NikitaKozelko/ModuleLedPanel/doc/pic/QlnexnhgFjM.jpg

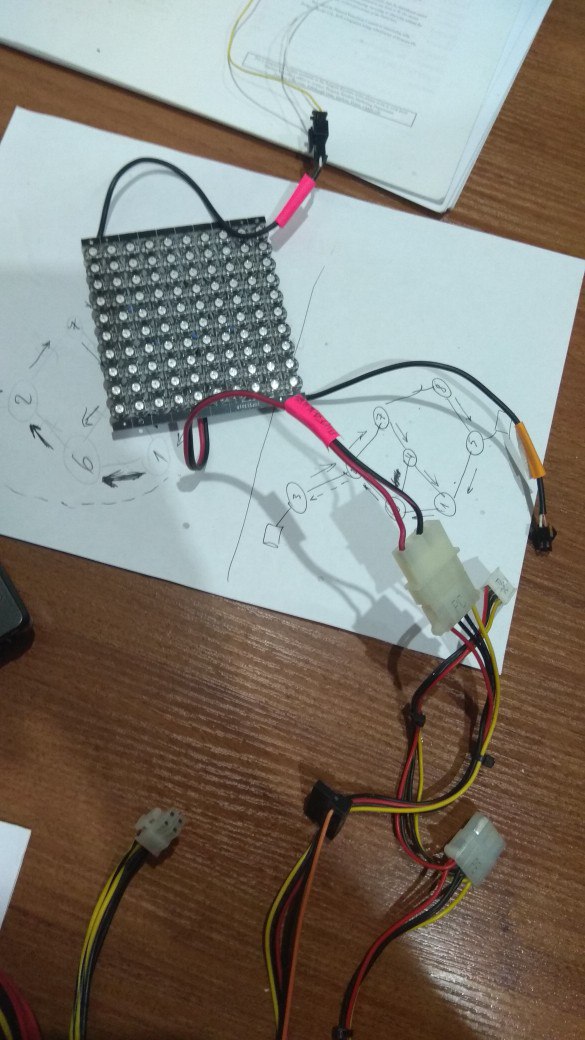
doc/pic/QlnexnhgFjM.jpg
