NikitaKozelko/ModuleLedPanel/doc/pic/BiGQELAHoDM.jpg

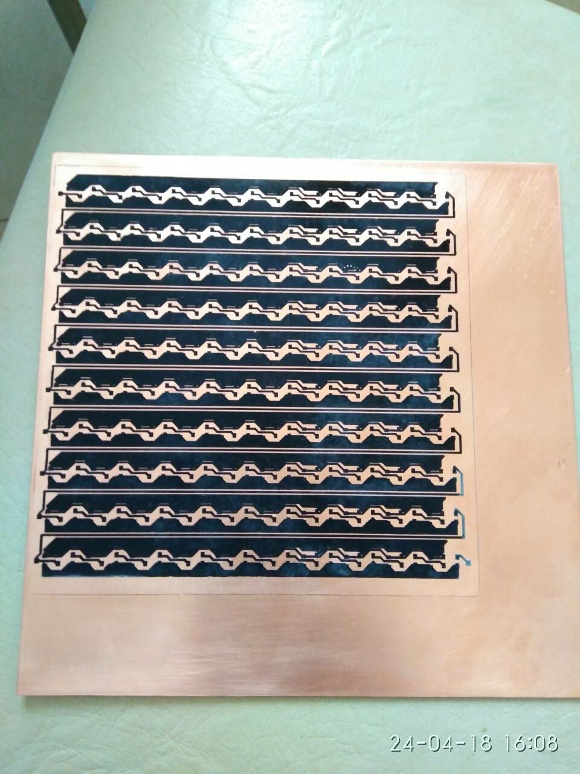
doc/pic/BiGQELAHoDM.jpg
