NikitaKozelko/ModuleLedPanel/doc/Demo.pptx

## Курсовой проект по СИФО ЭВМ “RGB LED-панель с тремя модулями”

студентов группы 550504 Козелько Н. С. и Дорошко В. Э.

## Цель:

- Описание проекта:
- Собрать LED-панель из RGB светодиодов, которая будет отображать текст, вводимый в приложении на компьютере. А также протестировать устройство в условиях, при которых оно должно работать. И решить возникшие проблемы, если они появятся.
- Цель проекта:
- Получить новые знания и умения работы с Arduino, а также проверить уже полученные знания на практике.

## АНалоги

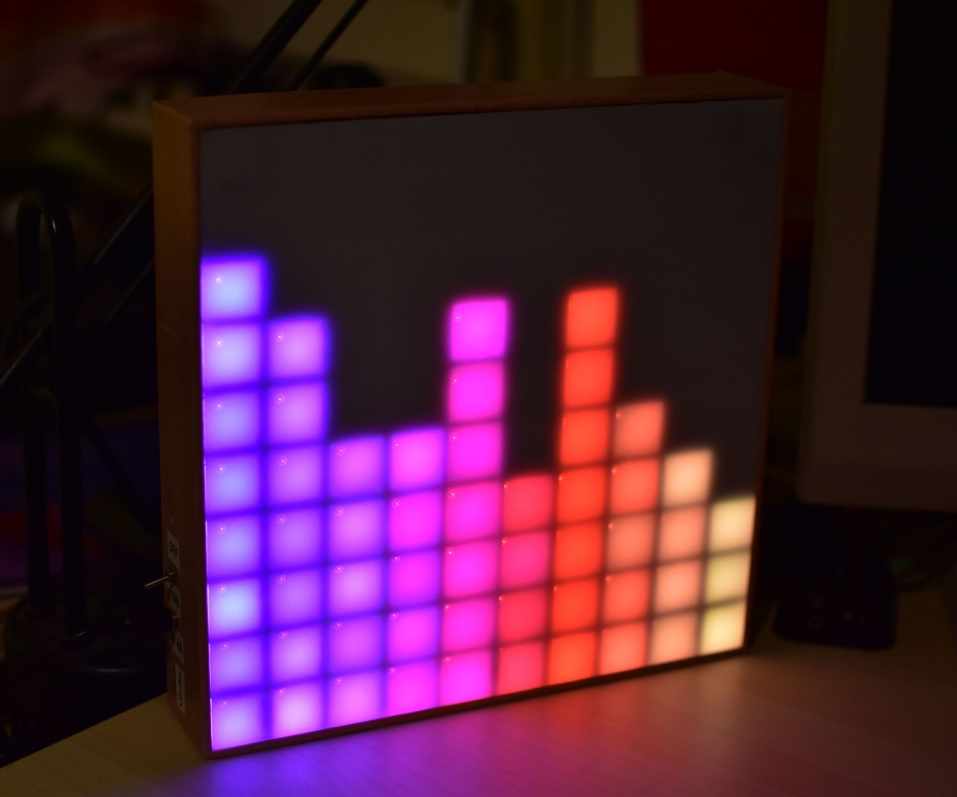
[picture p44: figure]

## Аппаратная часть


светодиод WS2812B

Схема работы

## Проектирование Аппаратной части


## Проектирование Аппаратной части


## Программная часть


## Программная часть


## Заказ деталей


## Вытравливание платы


## Вытравливание платы


## Вытравливание платы


## Вытравливание платы


## Вытравливание платы


## Вытравливание платы


## Вытравливание платы


## Интеграция программной и аппаратной части

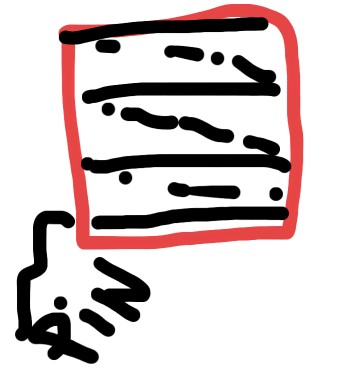
[picture p45: figure]

## Вытравливание платы

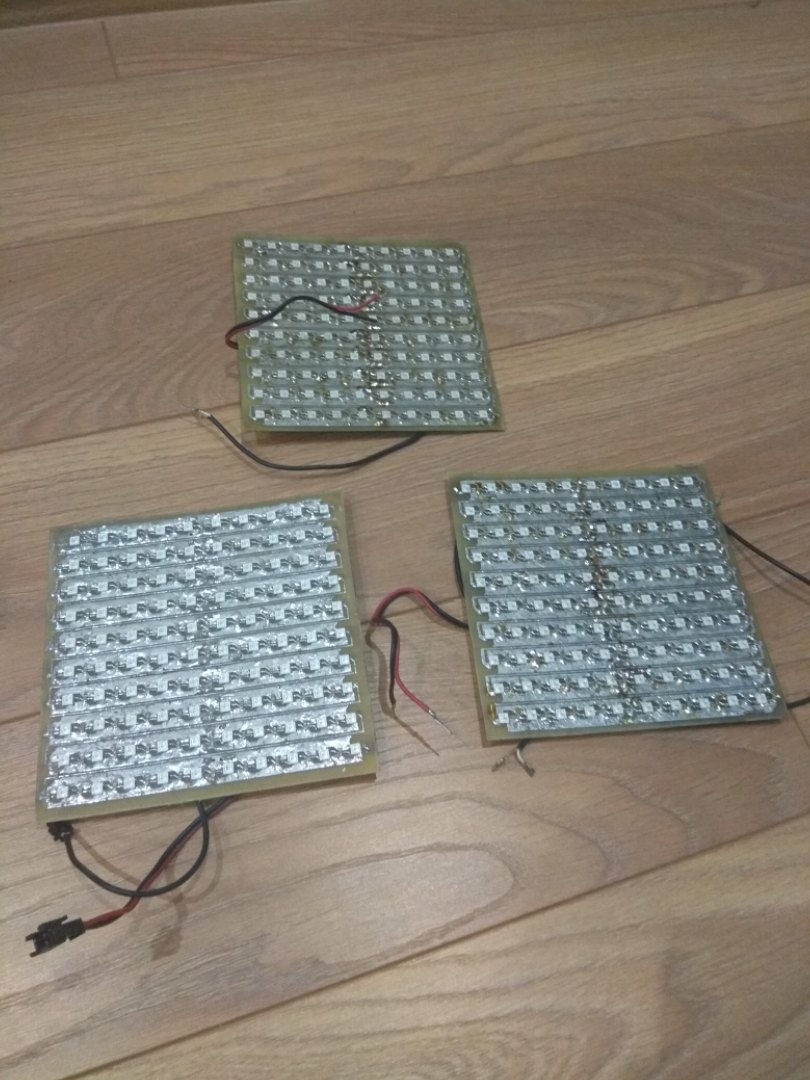
[picture p46: figure]

## Программная часть

Формат команды:
команда:
TEXT для вывода текста
UGLV для вывода изображения в угловом режиме
SNAK для последовательного зажигания всех светодиодов
- цвет:
- каждый цвет задается в формате от 0 до 255
- режим:
- определяет направление сдвига:
- 1: сдвигает слева направо в текстовом режиме
- 2: сдвигает справа налево в текстовом режиме
- 3: сдвигает изображение слева направо в угловом режиме
- 4: сдвигает изображение справа налево в угловом режиме

## Программная часть


## Программная часть


## Программная часть


## Проблемы в программной части

## Спасибо за внимание
