NikitaKozelko/ModuleLedPanel/doc/pic/k7k3CvZeT_w.jpg

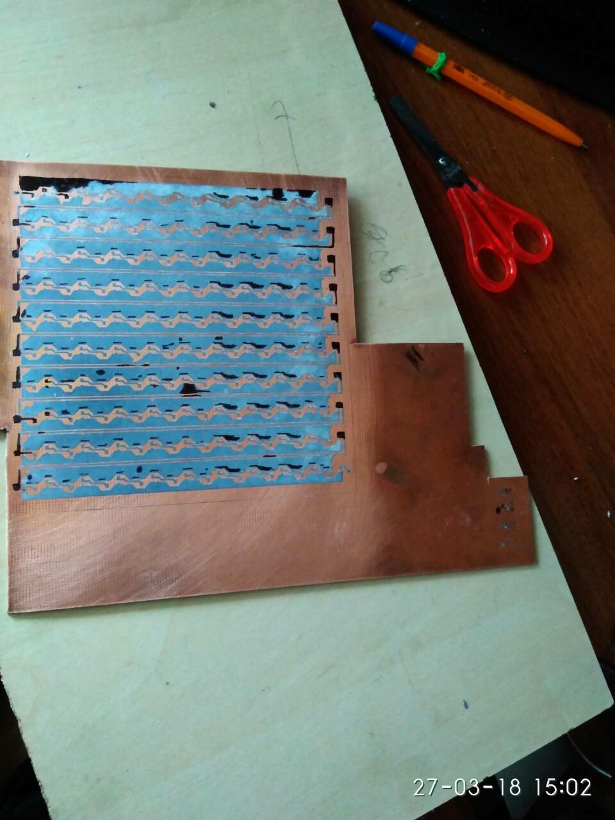
doc/pic/k7k3CvZeT_w.jpg
