NikitaKozelko/ModuleLedPanel/doc/pic/lSbHtu9iDFY.jpg

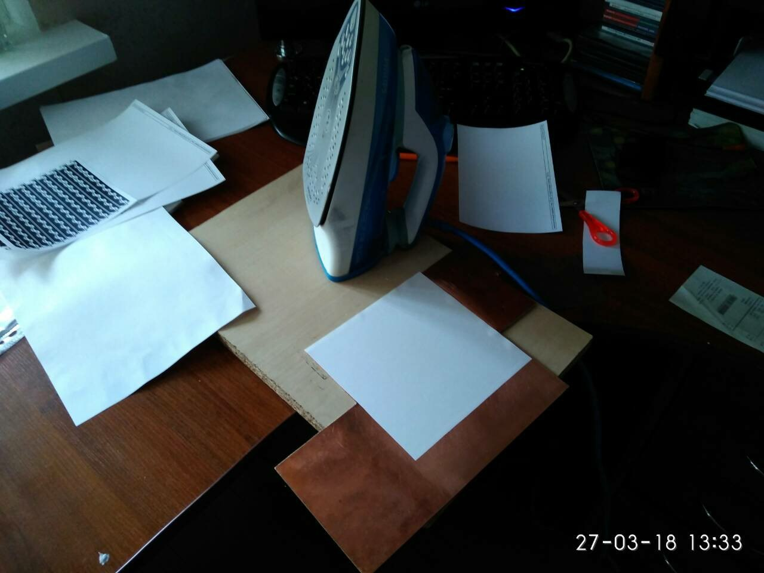
doc/pic/lSbHtu9iDFY.jpg
