NikitaKozelko/ModuleLedPanel/doc/pic/S7ioBkAFCrk.jpg

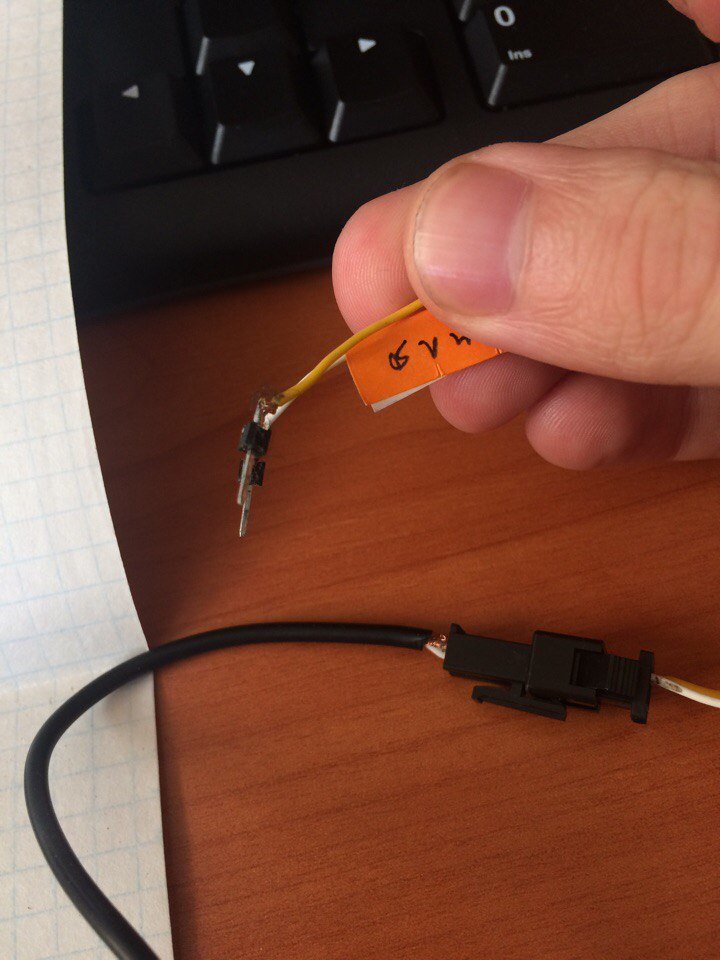
doc/pic/S7ioBkAFCrk.jpg
