NikitaKozelko/ModuleLedPanel/doc/pic/Screenshot_5.jpg

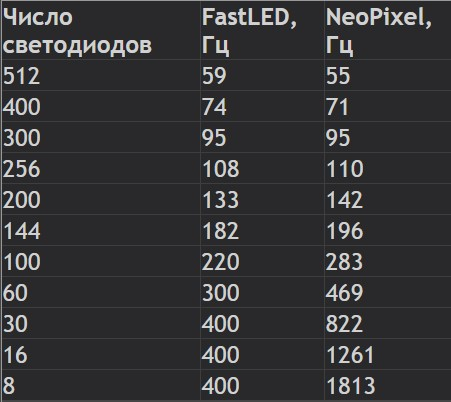
doc/pic/Screenshot_5.jpg
