NikitaKozelko/ModuleLedPanel/doc/pic/T2O9y2spIOo.jpg

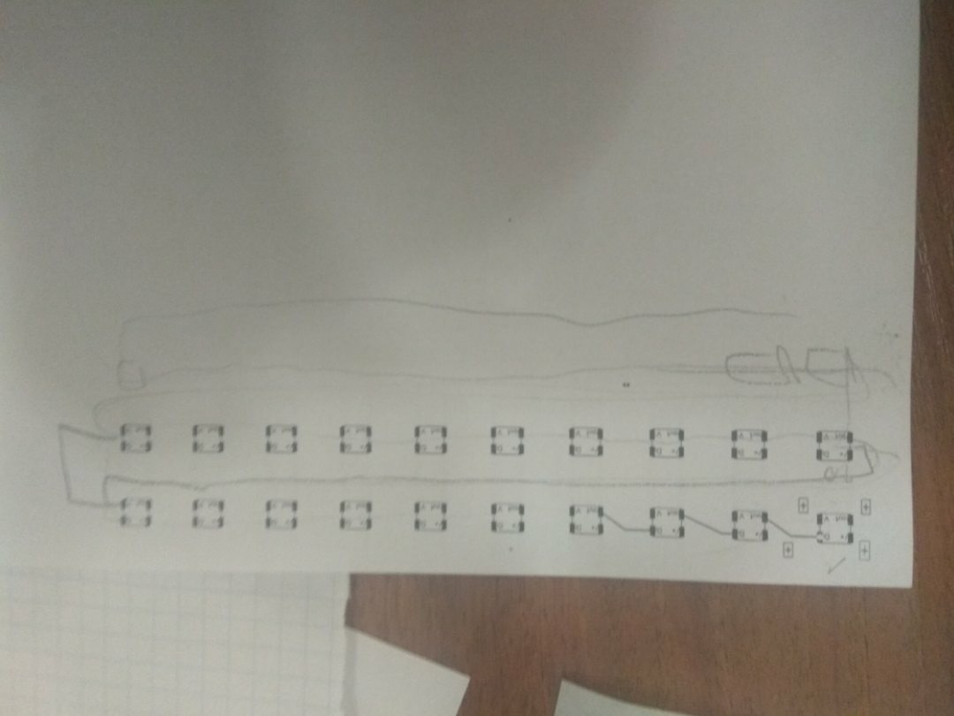
doc/pic/T2O9y2spIOo.jpg
