NikitaKozelko/ModuleLedPanel/doc/pic/UgxTbplSG3E.jpg

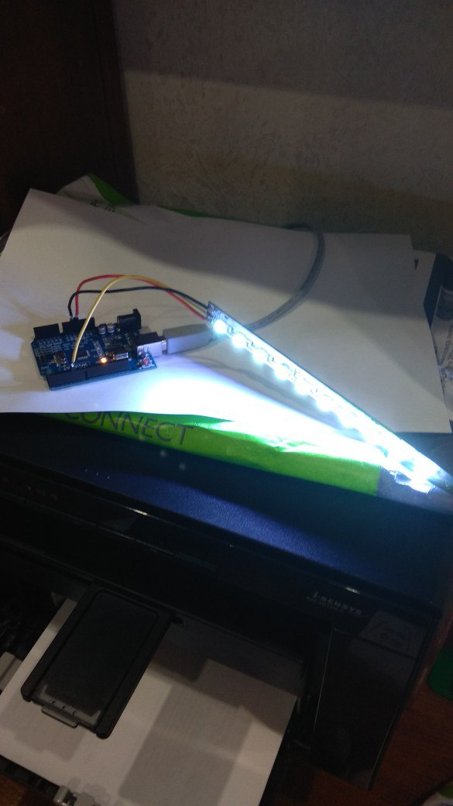
doc/pic/UgxTbplSG3E.jpg
