NikitaKozelko/ModuleLedPanel/WpfApplicationForArduino/WpfApplicationForArduino/src/mode1.jpg

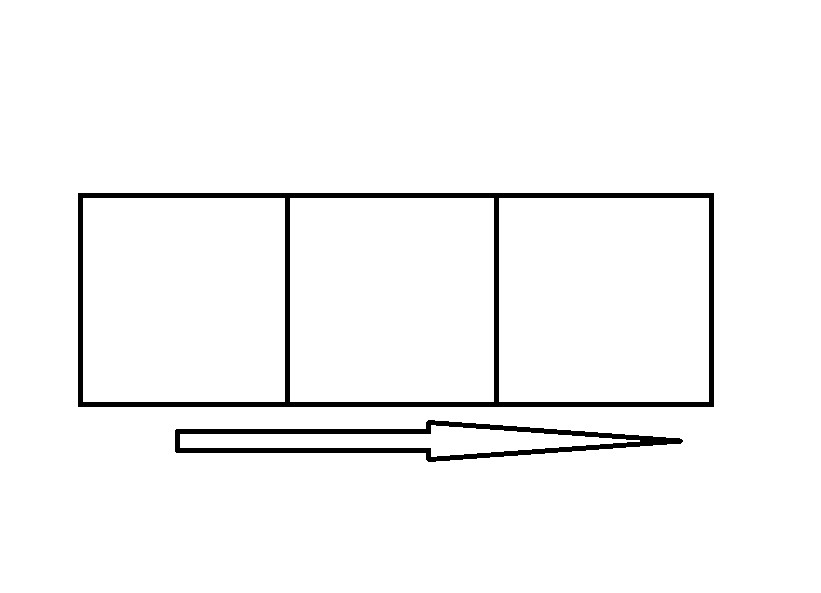
WpfApplicationForArduino/WpfApplicationForArduino/src/mode1.jpg
