NikitaKozelko/ModuleLedPanel/WpfApplicationForArduino/WpfApplicationForArduino/src/mode3.jpg

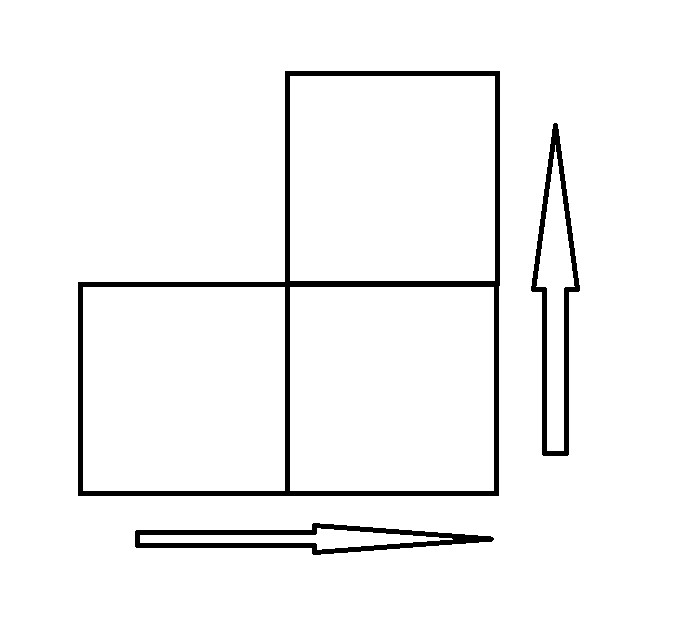
WpfApplicationForArduino/WpfApplicationForArduino/src/mode3.jpg
