NikitaKozelko/ModuleLedPanel/WpfApplicationForArduino/WpfApplicationForArduino/src/mode4.jpg

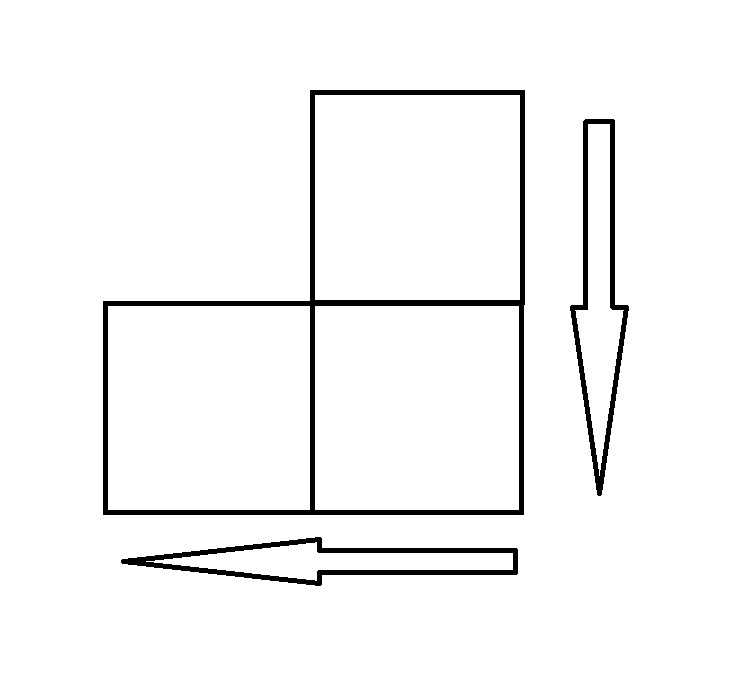
WpfApplicationForArduino/WpfApplicationForArduino/src/mode4.jpg
