NikitaKozelko/ModuleLedPanel/(commit log)

2018-04-09 Added sketch for arduino.
2018-04-09 Added method for fire first led from command.
2018-04-16 Added sketch for test all diodes.
2018-04-16 Fix the bags with print text in line. Added new mode with print text in reverse line.
    [finalSketch.ino]
2018-05-09 Added documentation and fix some bugs with uglv mode.
    [finalSketch.ino, testSnake.ino]
